ptr727/DevKitCIoT/fabrication/DevKitCIoT_BOM.csv

References | Value | Footprint | Quantity | MPN | CPL
C1 C3 | 47u | Capacitor_THT:CP_Radial_D5.0mm_P2.50mm | 2 |  | CPL-CAP-ALU-RAD-47UF-50V
C2 C4 | 100n | Capacitor_THT:C_Disc_D3.0mm_W2.0mm_P2.50mm | 2 |  | 100n 25V
D1 | HLMP-3507 | LED_THT:LED_D5.0mm | 1 | HLMP-3507
D2 | HLMP-3301 | LED_THT:LED_D5.0mm | 1 | HLMP-3301
D3 | HLMP-D401 | LED_THT:LED_D5.0mm | 1 | HLMP-D401
D4 | SB1H100-E3/54 | Diode_THT:D_DO-41_SOD81_P7.62mm_Horizontal | 1 | SB1H100-E3/54
F1 | 39215000440 | DevKitCIoT:Fuse_Littelfuse_392Series | 1 | 39215000440
J1 | 1862453 | DevKitCIoT:TerminalBlock_Phoenix_SPTAF-1-6-5.0-EL_1x06_P5.0mm_Horizontal | 1 | 1862453
J2 | 1862055 | DevKitCIoT:TerminalBlock_Phoenix_SPTAF-1-3-3.5-EL_1x03_P3.5mm_Horizontal | 1 | 1862055
J3 | 1862068 | DevKitCIoT:TerminalBlock_Phoenix_SPTAF-1-4-3.5-EL_1x04_P3.5mm_Horizontal | 1 | 1862068
K1 | G5Q-1 | DevKitCIoT:Relay_SPDT_Omron_G5Q-1 | 1 | G5Q-14 DC5
PS1 | RAC03-05SK | DevKitCIoT:Converter_ACDC_RECOM_RAC03-xxSK_THT | 1 | RAC03-05SK
Q1 | BS270 | Package_TO_SOT_THT:TO-92_Inline_Wide | 1 | BS270
R1 R2 | 300 | Resistor_THT:R_Axial_DIN0207_L6.3mm_D2.5mm_P7.62mm_Horizontal | 2 |  | 300 0.25W 5%
R3 | 4k7 | Resistor_THT:R_Axial_DIN0207_L6.3mm_D2.5mm_P7.62mm_Horizontal | 1 |  | 4.7k 0.25W 5%
R4 | 130 | Resistor_THT:R_Axial_DIN0207_L6.3mm_D2.5mm_P7.62mm_Horizontal | 1 |  | 130 0.25W 5%
R5 | 10k | Resistor_THT:R_Axial_DIN0207_L6.3mm_D2.5mm_P7.62mm_Horizontal | 1 |  | 10k 0.25W 5%
R6 | 1k | Resistor_THT:R_Axial_DIN0207_L6.3mm_D2.5mm_P7.62mm_Horizontal | 1 |  | 1k 0.25W 5%
R7 R9 | 750 | Resistor_THT:R_Axial_DIN0207_L6.3mm_D2.5mm_P7.62mm_Horizontal | 2 |  | 750 0.25W 5%
R8 R10 | 4.7k | Resistor_THT:R_Axial_DIN0207_L6.3mm_D2.5mm_P7.62mm_Horizontal | 2 |  | 4.7k 0.25W 5%
U1 | DS18B20 | Package_TO_SOT_THT:TO-92_Inline_Wide | 1 | DS18B20+
U2 | ACPL-827 | Package_DIP:DIP-8_W7.62mm | 1 | ACPL-827-00CE
U3 | ESP32-DevKitCVE | DevKitCIoT:RF_Module_ESP32-DevKitC | 1 | ESP32-DevKitCVE
