ptr727/DevKitCIoT/docs/DevKitCIoT_Schematic.pdf

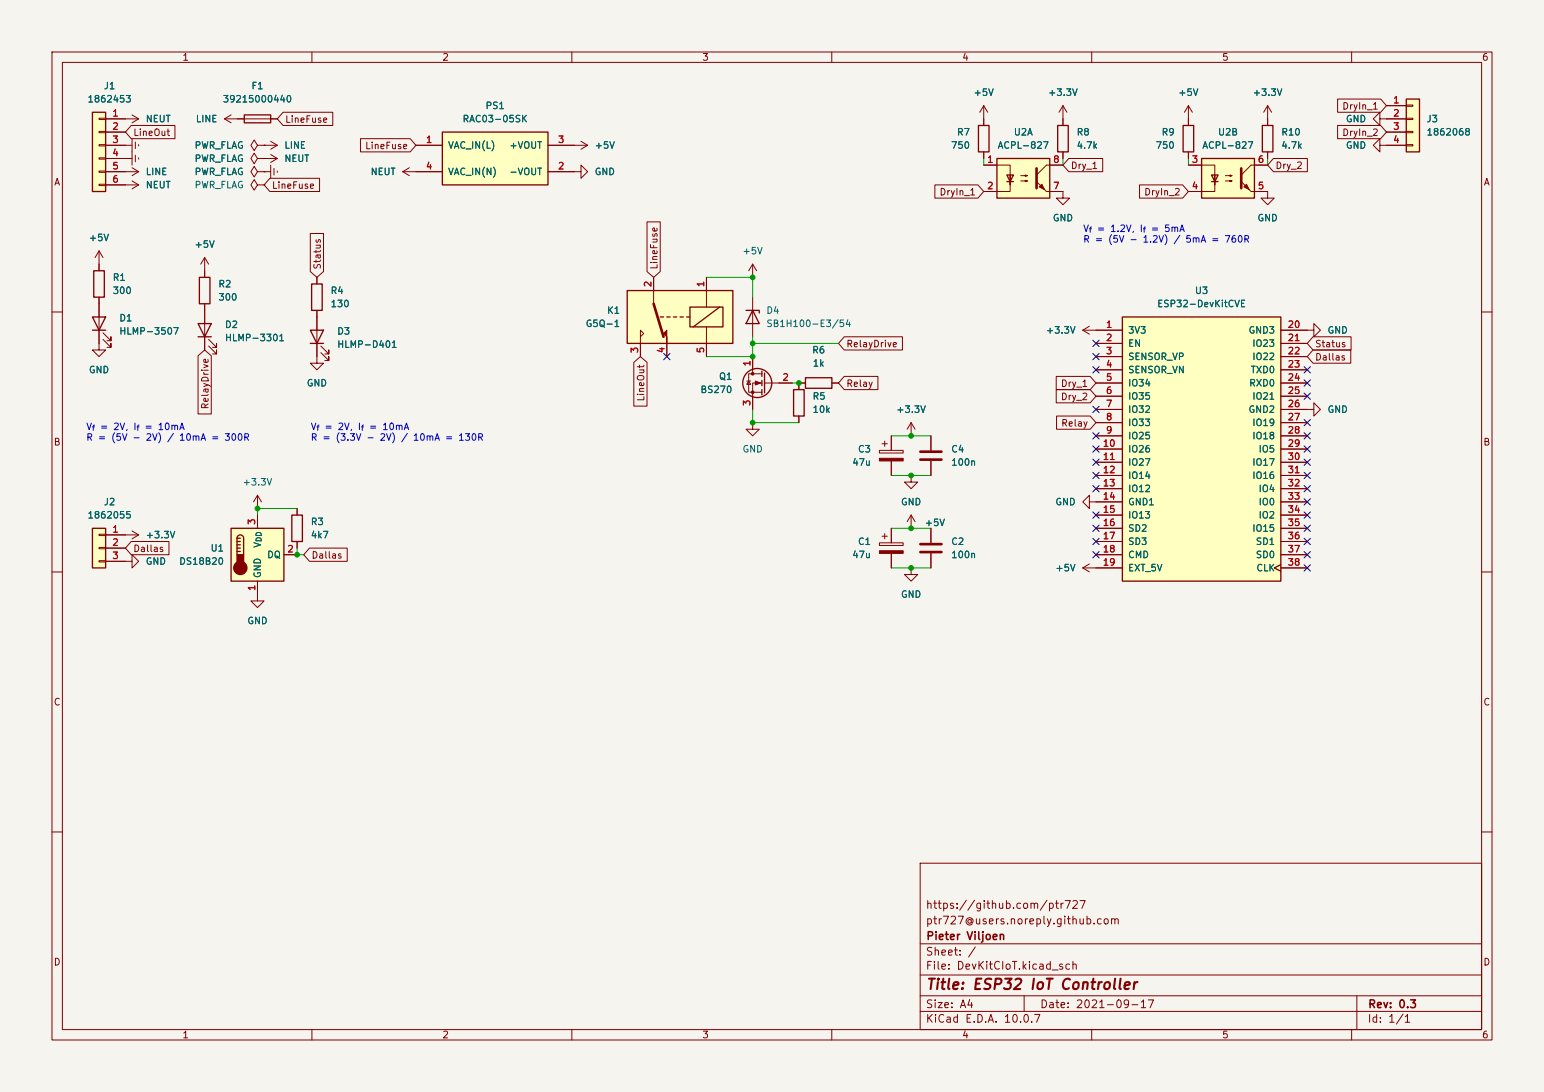
[picture p3: page 1]

https://github.com/ptr727
ptr727@users.noreply.github.com
Pieter Viljoen
Sheet: /
File: DevKitCIoT.kicad_sch
Title: ESP32 IoT Controller

Size: A4 | Rev: 0.3
KiCad E.D.A. 10.0.7 | Id: 1/1
