ptr727/DevKitCIoT/DevKitCIoT.kicad_pcb

## KiCad design DevKitCIoT.kicad_pcb (2026-11-08)

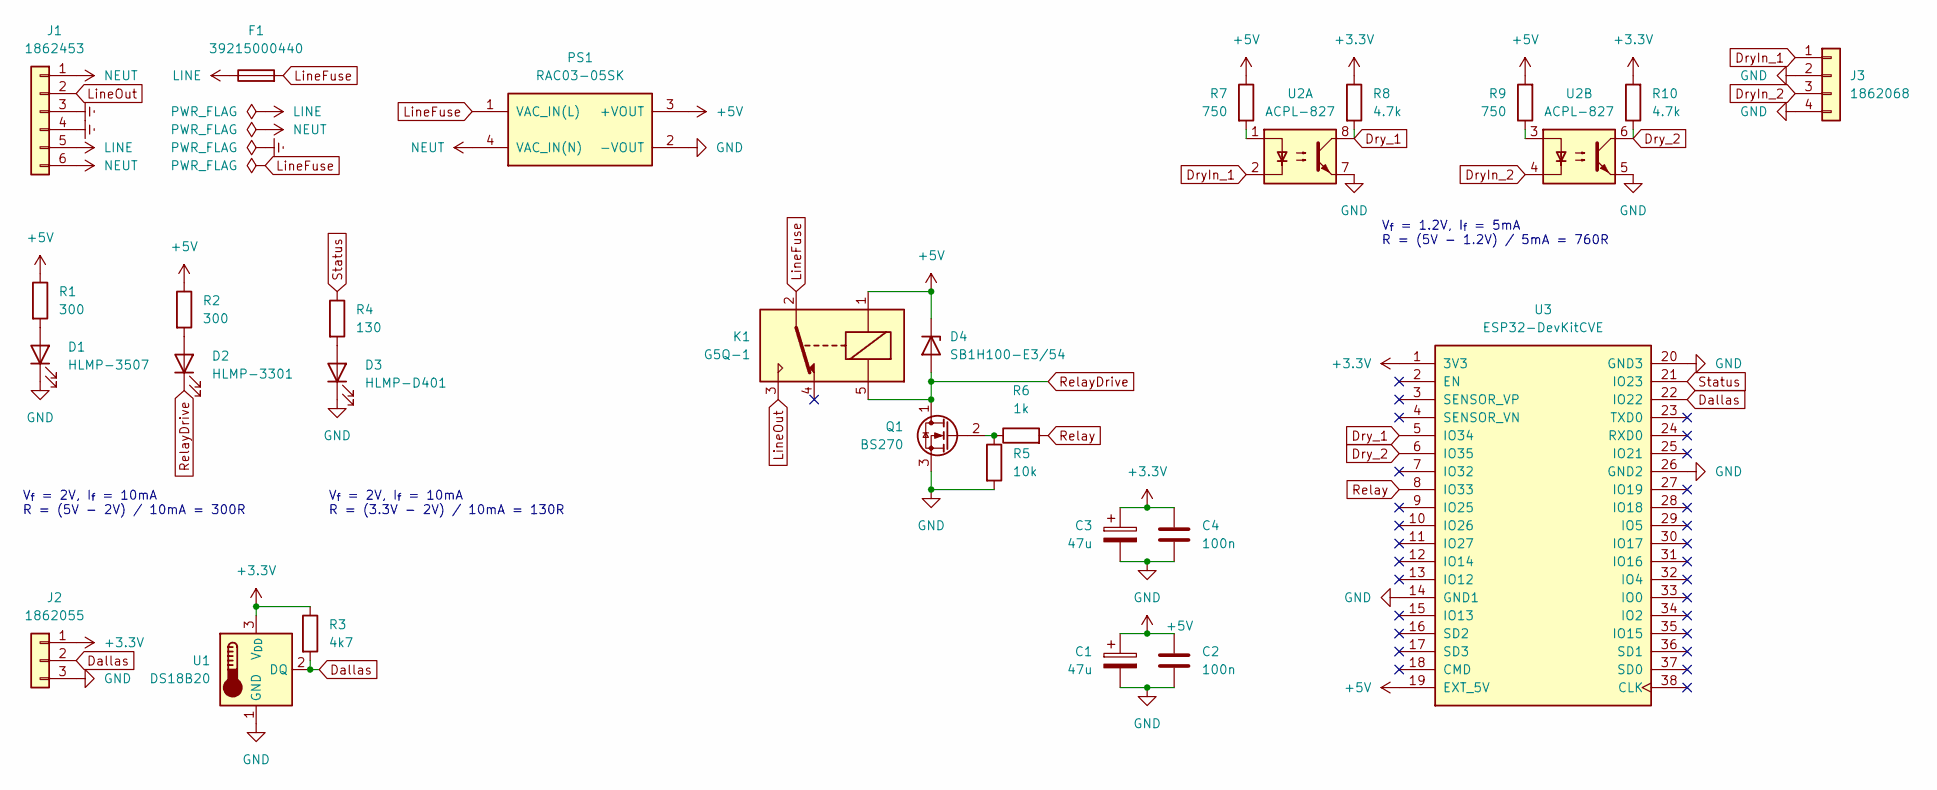
[picture p4: schematic DevKitCIoT.kicad_sch, ESP32 IoT Controller]

Parts:
C1, C3: 47u; CP_Radial_D5.0mm_P2.50mm
C2, C4: 100n; C_Disc_D3.0mm_W2.0mm_P2.50mm
D1: HLMP-3507; LED_D5.0mm; MPN HLMP-3507
D2: HLMP-3301; LED_D5.0mm; MPN HLMP-3301
D3: HLMP-D401; LED_D5.0mm; MPN HLMP-D401
D4: SB1H100-E3/54; D_DO-41_SOD81_P7.62mm_Horizontal; MPN SB1H100-E3/54
F1: 39215000440; Fuse_Littelfuse_392Series; MPN 39215000440
J1: 1862453; TerminalBlock_Phoenix_SPTAF-1-6-5.0-EL_1x06_P5.0mm_Horizont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; MPN 1862453
J2: 1862055; TerminalBlock_Phoenix_SPTAF-1-3-3.5-EL_1x03_P3.5mm_Horizont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; MPN 1862055
J3: 1862068; TerminalBlock_Phoenix_SPTAF-1-4-3.5-EL_1x04_P3.5mm_Horizont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; MPN 1862068
K1: G5Q-1; Relay_SPDT_Omron_G5Q-1; MPN G5Q-14 DC5
PS1: RAC03-05SK; Converter_ACDC_RECOM_RAC03-xxSK_THT; MPN RAC03-05SK
Q1: BS270; TO-92_Inline_Wide; MPN BS270
R1, R2: 300; R_Axial_DIN0207_L6.3mm_D2.5mm_P7.62mm_Horizontal
R3: 4k7; R_Axial_DIN0207_L6.3mm_D2.5mm_P7.62mm_Horizontal
R4: 130; R_Axial_DIN0207_L6.3mm_D2.5mm_P7.62mm_Horizontal
R5: 10k; R_Axial_DIN0207_L6.3mm_D2.5mm_P7.62mm_Horizontal
R6: 1k; R_Axial_DIN0207_L6.3mm_D2.5mm_P7.62mm_Horizontal
R7, R9: 750; R_Axial_DIN0207_L6.3mm_D2.5mm_P7.62mm_Horizontal
R8, R10: 4.7k; R_Axial_DIN0207_L6.3mm_D2.5mm_P7.62mm_Horizontal
U1: DS18B20; TO-92_Inline_Wide; MPN DS18B20+
U2: ACPL-827; DIP-8_W7.62mm; MPN ACPL-827-00CE
U3: ESP32-DevKitCVE; RF_Module_ESP32-DevKitC; MPN ESP32-DevKitCVE

Connections:
+3.3V: C3.1, C4.1, J2.1, R3.1, R8.1, R10.2, U1.3 (V_{DD}), U3.1 (3V3)
+5V: C1.1, C2.1, D4.1 (K), K1.1, PS1.3 (+VOUT), R1.1, R2.1, R7.1, R9.2, U3.19 (EXT_5V)
Dallas: J2.2, R3.2, U1.2 (DQ), U3.22 (IO22)
DryIn_1: J3.1, U2.2
DryIn_2: J3.3, U2.4
Dry_1: R8.2, U2.8, U3.5 (IO34)
Dry_2: R10.1, U2.6, U3.6 (IO35)
Earth: J1.3, J1.4
GND: C1.2, C2.2, C3.2, C4.2, D1.1 (K), D3.1 (K), J2.3, J3.2, J3.4, PS1.2 (-VOUT), Q1.3 (S), R5.2, U1.1 (GND), U2.5, U2.7, U3.14 (GND1), U3.20 (GND3), U3.26 (GND2)
LINE: F1.1, J1.5
LineFuse: F1.2, K1.2, PS1.1 (VAC_IN(L))
LineOut: J1.2, K1.3
NEUT: J1.1, J1.6, PS1.4 (VAC_IN(N))
unnamed: D1.2 (A), R1.2
unnamed: D2.2 (A), R2.2
unnamed: D3.2 (A), R4.2
unnamed: Q1.2 (G), R5.1, R6.1
unnamed: R7.2, U2.1
unnamed: R9.1, U2.3
Relay: R6.2, U3.8 (IO33)
RelayDrive: D2.1 (K), D4.2 (A), K1.5, Q1.1 (D)
Status: R4.1, U3.21 (IO23)

Notes on the sheet:
V_{f} = 2V, I_{f} = 10mA R = (3.3V - 2V) / 10mA = 130R
V_{f} = 1.2V, I_{f} = 5mA R = (5V - 1.2V) / 5mA = 760R
V_{f} = 2V, I_{f} = 10mA R = (5V - 2V) / 10mA = 300R

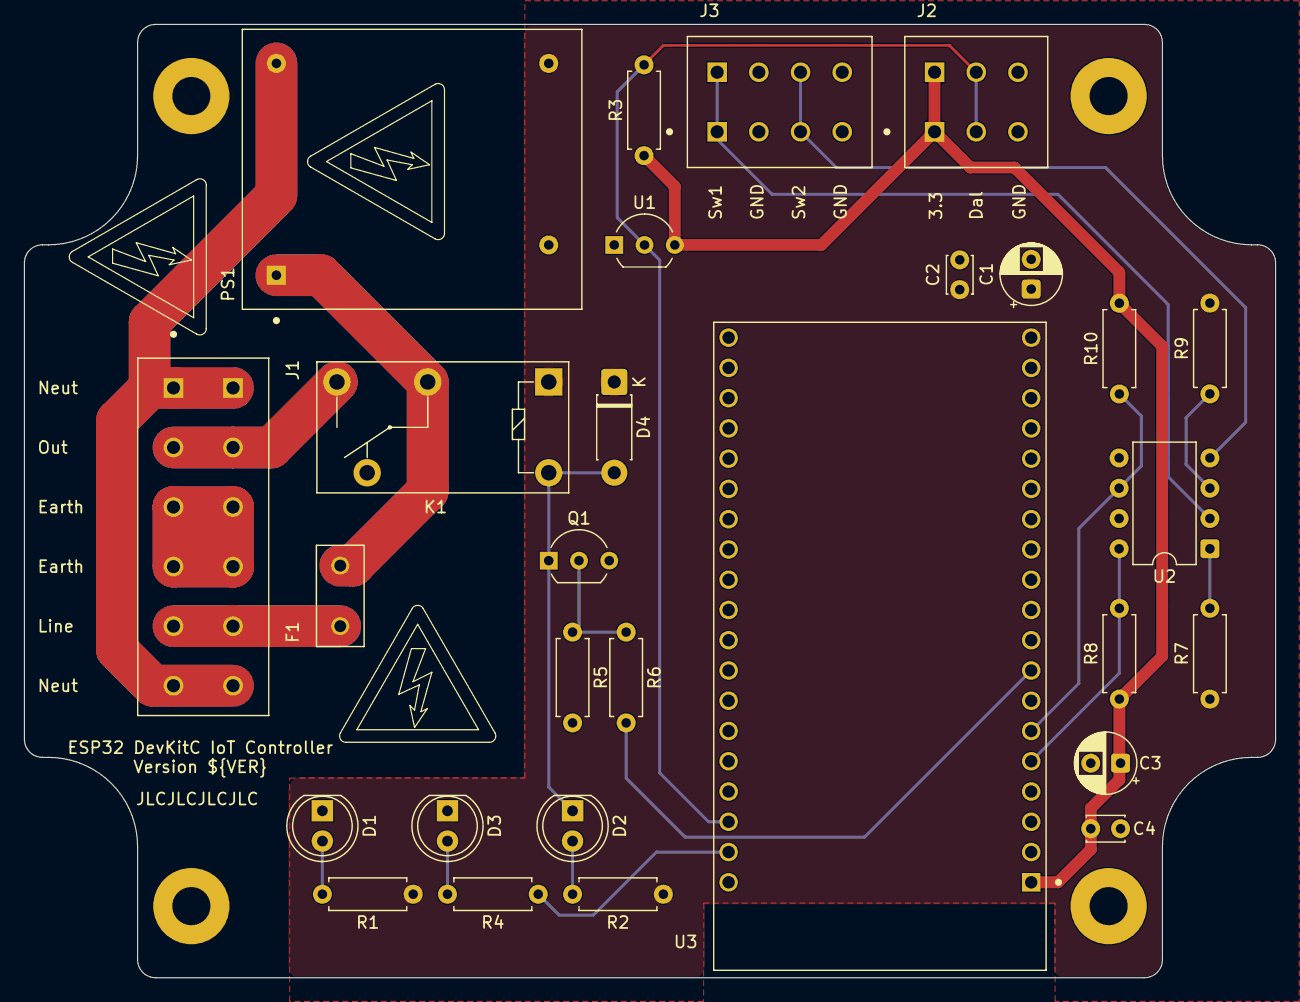
[picture p5: board DevKitCIoT.kicad_pcb from above]

Board: 2 copper layers, 105.0 x 80.0 mm, 32 parts (0 on the bottom side), 22 nets.

Other parts of the board:
H1, H2, H3, H4: MountingHole; MountingHole_3.2mm_M3_Pad
